eelstretching/led-budget-board/production/bom-full.csv

Comment | Designator | Footprint | LCSC | Manufacturer PN | Qty | Note
2.54-1*20P female header | A1A,A1B | PinSocket_1x20_P2.54mm_Vertical | C2905423 | Kinghelm KH-2.54FH-1X20P-H8.5 | 2 | Through-hole
10u | C1,C2 | C_0805_2012Metric | C440198 | CL21A106KBYNNNE | 2
100n | C3,C4 | C_0603_1608Metric | C14663 | CC0603KRX7R9BB104 | 2
75p | C5 | C_0402_1005Metric | C37809 | 0402CG750J500NT | 1
22u | C6,C7,C8 | C_0805_2012Metric | C45783 | CL21A226MAQNNNE | 3
100n | C9,C10,C11,C12 | C_0402_1005Metric | C1525 | CL05B104KO5NNNC | 4
SS34 | D1 | D_SMA | C8678 | SS34 | 1
B5819W | D2 | D_SOD-123 | C8598 | B5819W SL | 1
Green | D3 | LED_0603_1608Metric | C2289 | KT-0603YG | 1
12V IN | J1 | CONN-TH_2P-P9.50_DBT50G-9.5-2P | C395958 | DBT50G-9.5-2P | 1 | Through-hole
OUT1 | J2,J3 | IDC-Header_2x08_P2.54mm_Vertical | C3406 | 2.54-2*8P | 2 | Through-hole
UART | J4 | PinHeader_1x03_P2.54mm_Vertical | C49257 | 2.54-1*3P | 1 | Through-hole
I2C | J5 | PinHeader_1x04_P2.54mm_Vertical | C124378 | B-2100S04P-A110 | 1 | Through-hole
SPARE | J6 | PinHeader_1x08_P2.54mm_Vertical | C124381 | B-2100S08P-A110 | 1 | Through-hole
STEMMA QT | J7 | JST_SH_SM04B-SRSS-TB_1x04-1MP_P1.00mm_Horizontal | C160404 | SM04B-SRSS-TB(LF)(SN) | 1
15u | L1 | L_Sunlord_SWPA8040S | C16853 | SWPA8040S150MT | 1
510k | R1 | R_0402_1005Metric | C11616 | 0402WGF5103TCE | 1
100k | R2 | R_0402_1005Metric | C25741 | 0402WGF1003TCE | 1
13.3k | R3 | R_0402_1005Metric | C122547 | 0402WGF1332TCE | 1
1k | R4 | R_0402_1005Metric | C11702 | 0402WGF1001TCE | 1
33 | R5,R6,R7,R8,R9,R10,R11,R12,R13,R14,R15,R16,R17,R18,R19,R20 | R_0402_1005Metric | C25105 | 0402WGF330JTCE | 16
10k | R21,R22 | R_0402_1005Metric | C25744 | 0402WGF1002TCE | 2
RUN | SW1 | SW_SPST_TS-1088-xR025 | C455281 | TS-1088R-02526 | 1
TPS54202H | U1 | SOT-23-6 | C527684 | TPS54202HDDCR | 1
Pico 2 W | A1 | RaspberryPi_Pico_Common_THT |  | SC1633 | 1 | Not fitted by JLC: Raspberry Pi Pico 2 W (SC1633): yours, plugs into sockets A1A and A1B
M3 | H1 | MountingHole_3.2mm_M3 |  |  | 1 | Not fitted by JLC: M3 mounting hole
M3 | H2 | MountingHole_3.2mm_M3 |  |  | 1 | Not fitted by JLC: M3 mounting hole
M3 | H3 | MountingHole_3.2mm_M3 |  |  | 1 | Not fitted by JLC: M3 mounting hole
M3 | H4 | MountingHole_3.2mm_M3 |  |  | 1 | Not fitted by JLC: M3 mounting hole
