eelstretching/led-budget-board/docs/schematic.pdf

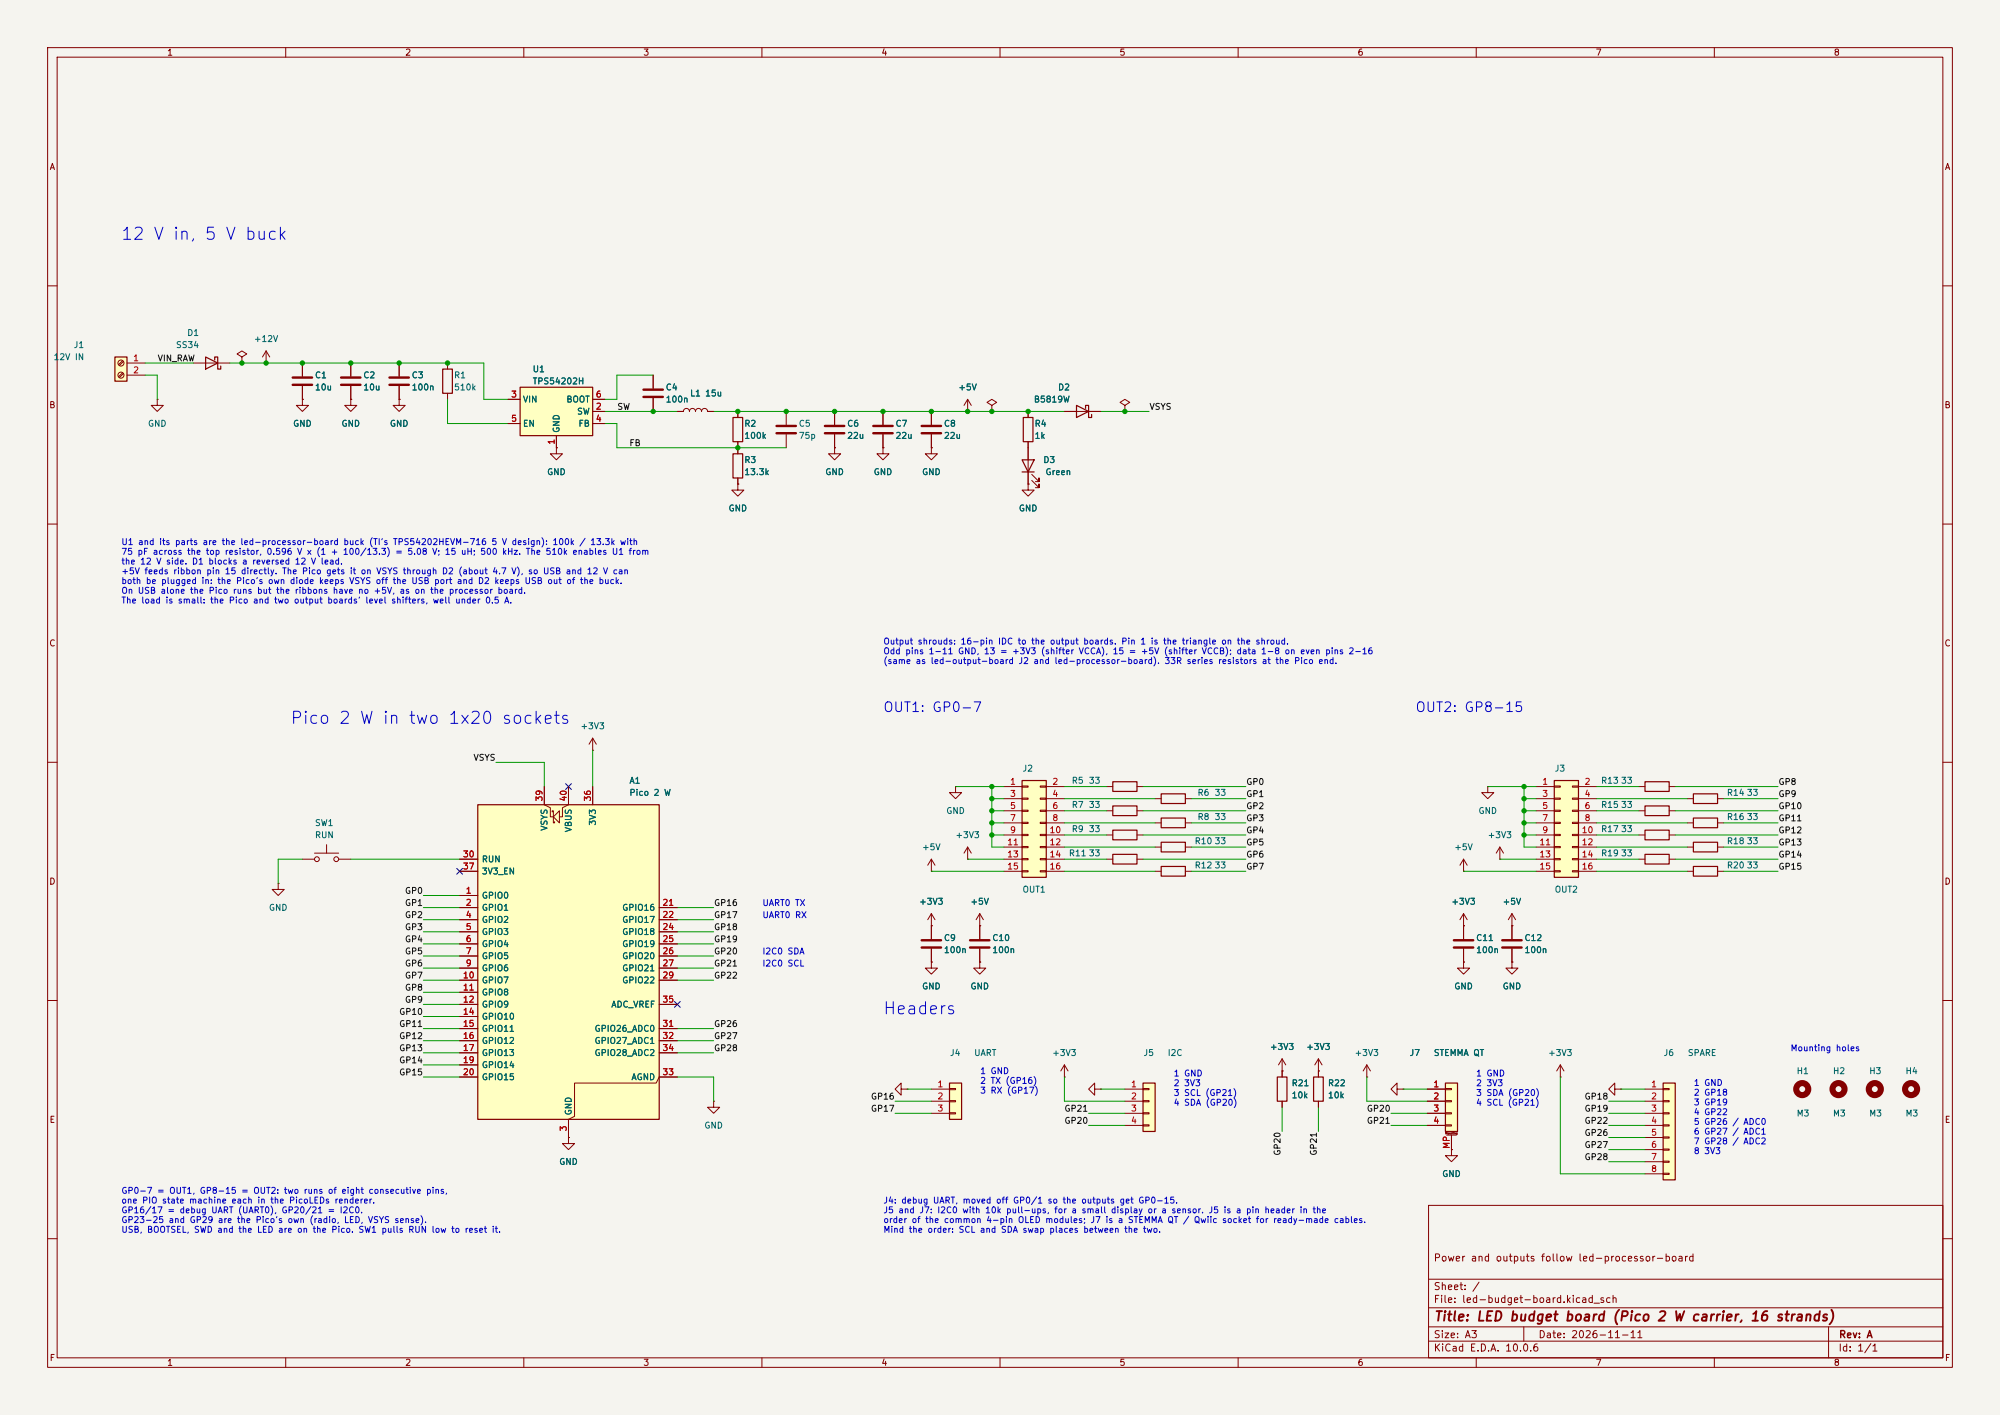
[picture p3: page 1]

U1 and its parts are the led-processor-board buck (TI's TPS54202HEVM-716 5 V design): 100k / 13.3k with 75 pF across the top resistor, 0.596 V x (1 + 100/13.3) = 5.08 V; 15 uH; 500 kHz. The 510k enables U1 from

the 12 V side. D1 blocks a reversed 12 V lead. +5V feeds ribbon pin 15 directly. The Pico gets it on VSYS through D2 (about 4.7 V), so USB and 12 V can

(same as led-output-board J2 and led-processor-board). 33R series resistors at the Pico end. Headers

3 SDA (GP20) 4 SCL (GP21) UART0 TX UART0 RX

GP0-7 = OUT1, GP8-15 = OUT2: two runs of eight consecutive pins, one PIO state machine each in the PicoLEDs renderer. GP16/17 = debug UART (UART0), GP20/21 = I2C0. GP23-25 and GP29 are the Pico's own (radio, LED, VSYS sense).

J4: debug UART, moved off GP0/1 so the outputs get GP0-15. J5 and J7: I2C0 with 10k pull-ups, for a small display or a sensor. J5 is a pin header in the order of the common 4-pin OLED modules; J7 is a STEMMA QT / Qwiic socket for ready-made cables. Mind the order: SCL and SDA swap places between the two.

Power and outputs follow led-processor-board

Sheet: /
File: led-budget-board.kicad_sch
Title: LED budget board (Pico 2 W carrier, 16 strands)

Size: A3 | Rev: A | F Date: 2026-11-11
KiCad E.D.A. 10.0.6 | Id: 1/1
