eelstretching/led-budget-board/led-budget-board.kicad_pcb

## KiCad design led-budget-board.kicad_pcb (2026-11-12)

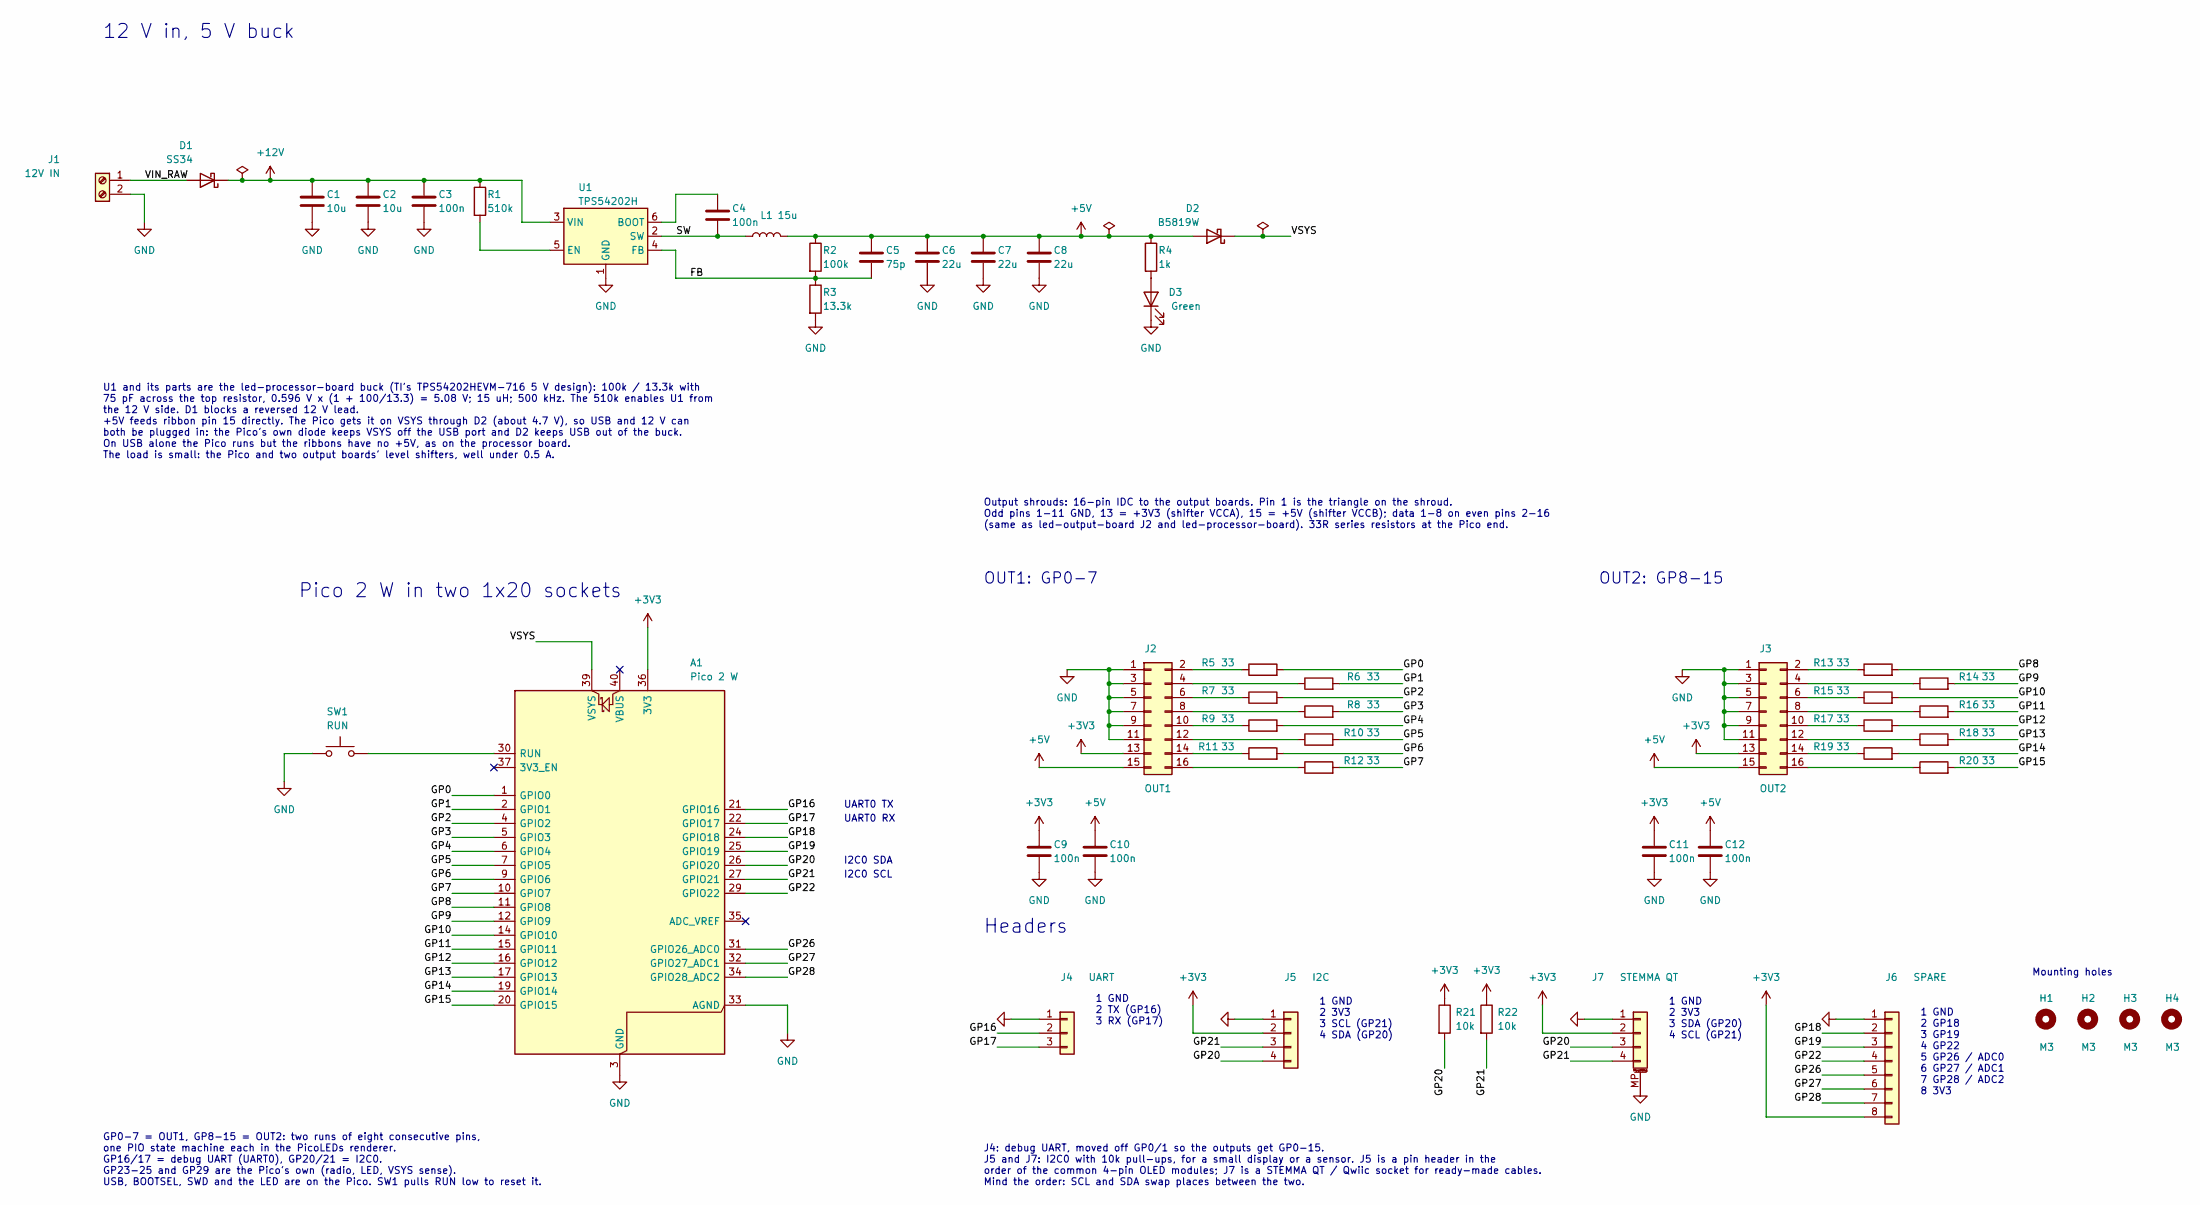
[picture p4: schematic led-budget-board.kicad_sch, LED budget board (Pico 2 W carrier, 16 strands)]

Parts:
A1: Pico 2 W; RaspberryPi_Pico_Common_THT; manufacturer_pn SC1633
C1, C2: 10u; C_0805_2012Metric; manufacturer_pn CL21A106KBYNNNE; LCSC C440198
C3, C4: 100n; C_0603_1608Metric; manufacturer_pn CC0603KRX7R9BB104; LCSC C14663
C5: 75p; C_0402_1005Metric; manufacturer_pn 0402CG750J500NT; LCSC C37809
C6, C7, C8: 22u; C_0805_2012Metric; manufacturer_pn CL21A226MAQNNNE; LCSC C45783
C9, C10, C11, C12: 100n; C_0402_1005Metric; manufacturer_pn CL05B104KO5NNNC; LCSC C1525
D1: SS34; D_SMA; manufacturer_pn SS34; LCSC C8678
D2: B5819W; D_SOD-123; manufacturer_pn B5819W SL; LCSC C8598
D3: Green; LED_0603_1608Metric; manufacturer_pn KT-0603YG; LCSC C2289
H1, H2, H3, H4: M3; MountingHole_3.2mm_M3
J1: 12V IN; CONN-TH_2P-P9.50_DBT50G-9.5-2P; manufacturer_pn DBT50G-9.5-2P; LCSC C395958
J2: OUT1; IDC-Header_2x08_P2.54mm_Vertical; manufacturer_pn 2.54-2*8P; LCSC C3406
J3: OUT2; IDC-Header_2x08_P2.54mm_Vertical; manufacturer_pn 2.54-2*8P; LCSC C3406
J4: UART; PinHeader_1x03_P2.54mm_Vertical; manufacturer_pn 2.54-1*3P; LCSC C49257
J5: I2C; PinHeader_1x04_P2.54mm_Vertical; manufacturer_pn B-2100S04P-A110; LCSC C124378
J6: SPARE; PinHeader_1x08_P2.54mm_Vertical; manufacturer_pn B-2100S08P-A110; LCSC C124381
J7: STEMMA QT; JST_SH_SM04B-SRSS-TB_1x04-1MP_P1.00mm_Horizontal; manufacturer_pn SM04B-SRSS-TB(LF)(SN); LCSC C160404
L1: 15u; L_Sunlord_SWPA8040S; manufacturer_pn SWPA8040S150MT; LCSC C16853
R1: 510k; R_0402_1005Metric; manufacturer_pn 0402WGF5103TCE; LCSC C11616
R2: 100k; R_0402_1005Metric; manufacturer_pn 0402WGF1003TCE; LCSC C25741
R3: 13.3k; R_0402_1005Metric; manufacturer_pn 0402WGF1332TCE; LCSC C122547
R4: 1k; R_0402_1005Metric; manufacturer_pn 0402WGF1001TCE; LCSC C11702
R5, R6, R7, R8, R9, R10, R11, R12, R13, R14, R15, R16, R17, R18, R19, R20: 33; R_0402_1005Metric; manufacturer_pn 0402WGF330JTCE; LCSC C25105
R21, R22: 10k; R_0402_1005Metric; manufacturer_pn 0402WGF1002TCE; LCSC C25744
SW1: RUN; SW_SPST_TS-1088-xR025; manufacturer_pn TS-1088R-02526; LCSC C455281
U1: TPS54202H; SOT-23-6; manufacturer_pn TPS54202HDDCR; LCSC C527684

Connections:
+3V3: A1.36 (3V3), C9.1, C11.1, J2.13, J3.13, J5.2, J6.8, J7.2, R21.1, R22.1
+5V: C5.1, C6.1, C7.1, C8.1, C10.1, C12.1, D2.2 (A), J2.15, J3.15, L1.2, R2.1, R4.1
+12V: C1.1, C2.1, C3.1, D1.1 (K), R1.1, U1.3 (VIN)
/FB: C5.2, R2.2, R3.1, U1.4 (FB)
/GP0: A1.1 (GPIO0), R5.2
/GP1: A1.2 (GPIO1), R6.2
/GP2: A1.4 (GPIO2), R7.2
/GP3: A1.5 (GPIO3), R8.2
/GP4: A1.6 (GPIO4), R9.2
/GP5: A1.7 (GPIO5), R10.2
/GP6: A1.9 (GPIO6), R11.2
/GP7: A1.10 (GPIO7), R12.2
/GP8: A1.11 (GPIO8), R13.2
/GP9: A1.12 (GPIO9), R14.2
/GP10: A1.14 (GPIO10), R15.2
/GP11: A1.15 (GPIO11), R16.2
/GP12: A1.16 (GPIO12), R17.2
/GP13: A1.17 (GPIO13), R18.2
/GP14: A1.19 (GPIO14), R19.2
/GP15: A1.20 (GPIO15), R20.2
/GP16: A1.21 (GPIO16), J4.2
/GP17: A1.22 (GPIO17), J4.3
/GP18: A1.24 (GPIO18), J6.2
/GP19: A1.25 (GPIO19), J6.3
/GP20: A1.26 (GPIO20), J5.4, J7.3, R21.2
/GP21: A1.27 (GPIO21), J5.3, J7.4, R22.2
/GP22: A1.29 (GPIO22), J6.4
/GP26: A1.31 (GPIO26_ADC0), J6.5
/GP27: A1.32 (GPIO27_ADC1), J6.6
/GP28: A1.34 (GPIO28_ADC2), J6.7
/SW: C4.2, L1.1, U1.2 (SW)
/VIN_RAW: D1.2 (A), J1.1
/VSYS: A1.39 (VSYS), D2.1 (K)
GND: A1.3 (GND), A1.8 (GND), A1.13 (GND), A1.18 (GND), A1.23 (GND), A1.28 (GND), A1.33 (AGND), A1.38 (GND), C1.2, C2.2, C3.2, C6.2, C7.2, C8.2, C9.2, C10.2, C11.2, C12.2, D3.1 (K), J1.2, J2.1, J2.3, J2.5, J2.7, J2.9, J2.11, J3.1, J3.3, J3.5, J3.7, J3.9, J3.11, J4.1, J5.1, J6.1, J7.1, J7.MP (MountPin), R3.2, SW1.1, U1.1 (GND)
unnamed: A1.30 (RUN), SW1.2
unnamed: D3.2 (A), R4.2
unnamed: J2.2, R5.1
unnamed: J2.4, R6.1
unnamed: J2.6, R7.1
unnamed: J2.8, R8.1
unnamed: J2.10, R9.1
unnamed: J2.12, R10.1
unnamed: J2.14, R11.1
unnamed: J2.16, R12.1
unnamed: J3.2, R13.1
unnamed: J3.4, R14.1
unnamed: J3.6, R15.1
unnamed: J3.8, R16.1
unnamed: J3.10, R17.1
unnamed: J3.12, R18.1
unnamed: J3.14, R19.1
unnamed: J3.16, R20.1
unnamed: C4.1, U1.6 (BOOT)
unnamed: R1.2, U1.5 (EN)

Notes on the sheet:
12 V in, 5 V buck
U1 and its parts are the led-processor-board buck (TI's TPS54202HEVM-716 5 V design): 100k / 13.3k with 75 pF across the top resistor, 0.596 V x (1 + 100/13.3) = 5.08 V; 15 uH; 500 kHz. The 510k enables U1 from the 12 V side. D1 blocks a reversed 12 V lead. +5V feeds ribbon pin 15 directly. The Pic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
Pico 2 W in two 1x20 sockets
UART0 TX
UART0 RX
I2C0 SDA
I2C0 SCL
GP0-7 = OUT1, GP8-15 = OUT2: two runs of eight consecutive pins, one PIO state machine each in the PicoLEDs renderer. GP16/17 = debug UART (UART0), GP20/21 = I2C0. GP23-25 and GP29 are the Pico's own (radio, LED, VSYS sense). USB, BOOTSEL, SWD and the LED are on the Pico. SW1 pulls RUN low to reset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
Output shrouds: 16-pin IDC to the output boards. Pin 1 is the triangle on the shroud. Odd pins 1-11 GND, 13 = +3V3 (shifter VCCA), 15 = +5V (shifter VCCB); data 1-8 on even pins 2-16 (same as led-output-board J2 and led-processor-board). 33R series resistors at the Pico end.
OUT1: GP0-7
OUT2: GP8-15
Headers
1 GND 2 TX (GP16) 3 RX (GP17)
1 GND 2 3V3 3 SCL (GP21) 4 SDA (GP20)
1 GND 2 3V3 3 SDA (GP20) 4 SCL (GP21)
1 GND 2 GP18 3 GP19 4 GP22 5 GP26 / ADC0 6 GP27 / ADC1 7 GP28 / ADC2 8 3V3
J4: debug UART, moved off GP0/1 so the outputs get GP0-15. J5 and J7: I2C0 with 10k pull-ups, for a small display or a sensor. J5 is a pin header in the order of the common 4-pin OLED modules; J7 is a STEMMA QT / Qwiic socket for ready-made cables. Mind the order: SCL and SDA swap places between th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
Mounting holes

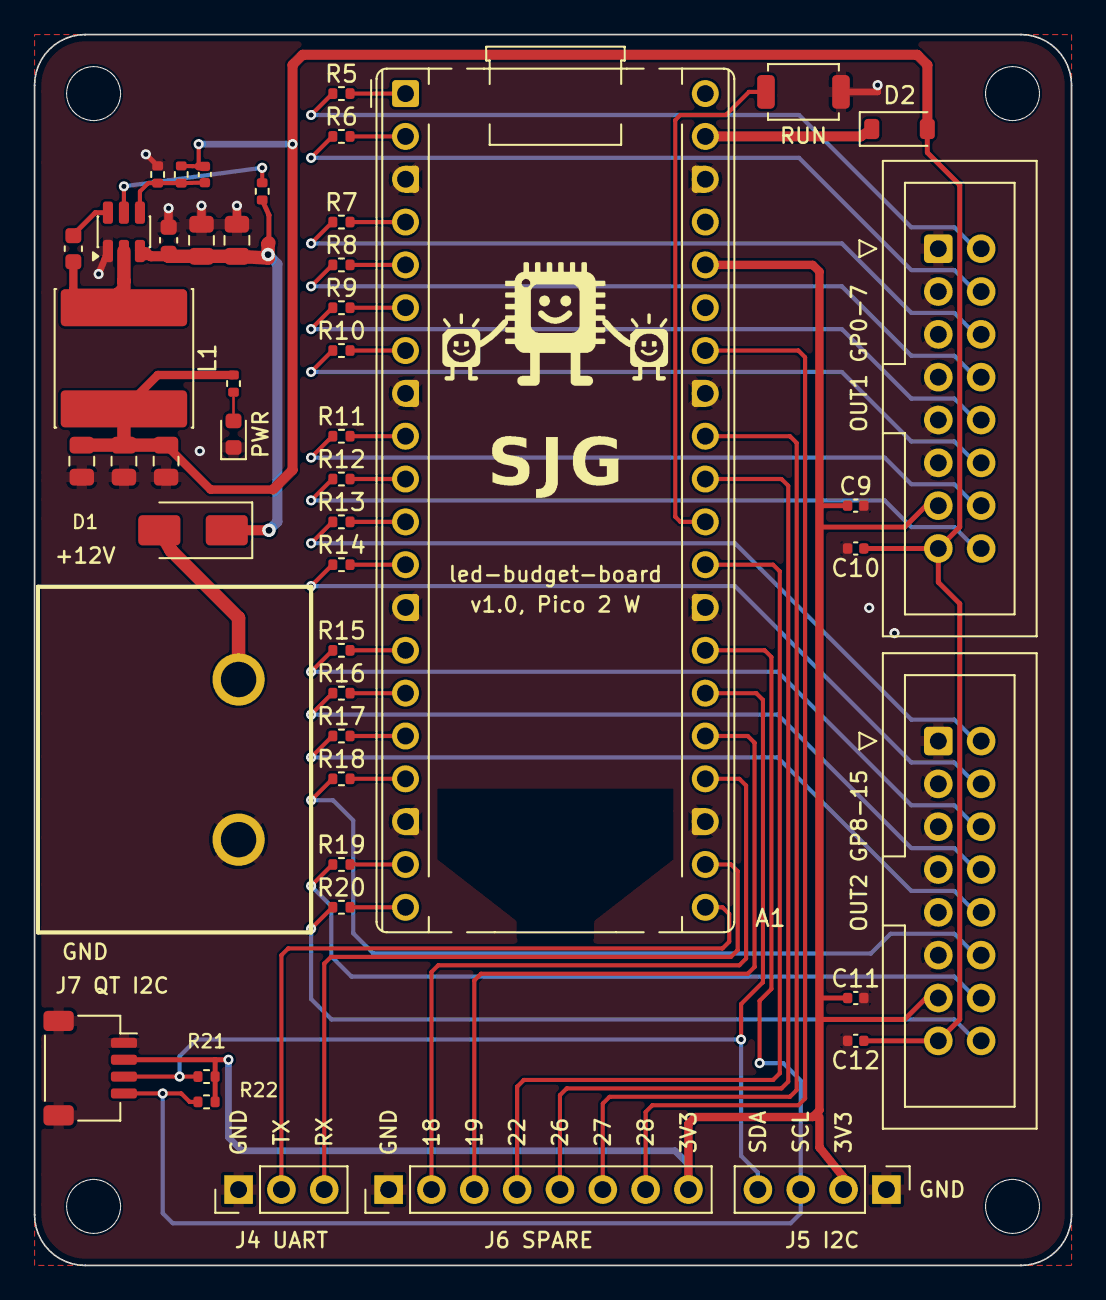
[picture p5: board led-budget-board.kicad_pcb from above]

Board: 2 copper layers, 61.5 x 73.0 mm, 53 parts (0 on the bottom side), 54 nets.

Other parts of the board:
G1: SJG_BigBrother
