eelstretching/led-budget-board/(commit log)

2026-11-11 Add the schematic: Pico 2 W carrier with two output shrouds
    One A3 sheet: a socketed Pico 2 W, OUT1 on GP0-7 and OUT2 on GP8-15 with
    33R series resistors, the led-processor-board 12 V to 5 V buck feeding the
    ribbons and (through a Schottky) the Pico's VSYS, debug UART header on
    GP16/17, I2C header on GP20/21, spare GPIO header, RUN button, mounting
    holes. ERC is clean.
    Claude-Session: https://claude.ai/code/session_01NSi48ZqyhrwW7HN2P3fnKd
    [led-budget-board.kicad_sch]
2026-11-11 Add a STEMMA QT socket on the I2C bus
    J7, a JST SH 4-pin socket (SM04B-SRSS-TB, LCSC C160404) in the STEMMA QT /
    Qwiic pin order (GND, 3V3, SDA, SCL), in parallel with the J5 pin header on
    GP20/GP21. Headers moved closer together to make room. ERC is clean.
    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
    [led-budget-board.kicad_sch]
2026-11-11 Start the PCB layout: placement and the planned data lines
    tools/pcb/build_pcb.py places every part, draws the 61.5 x 73 mm outline,
    routes the 16 data lines (33R next to the Pico, then across under the Pico
    on the bottom layer to the two shrouds on the right edge) and copies the
    processor board's 5 V buck layout. Not routed yet: power distribution,
    headers, button.
    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
    [led-budget-board.kicad_pcb]
2026-11-11 Route the board: all nets connected, DRC clean
    Hand-routed by tools/pcb/build_pcb.py: 12 V input, 5 V trunk to D2/VSYS and the
    shrouds, 3.3 V, RUN, UART, spare I/O and I2C (J5 header and J7 STEMMA QT).
    J6 pin order is now GND, GP18, GP19, GP22, GP26-28, 3V3 so the tracks reach it
    without crossing. RUN button and D2 moved to the top right; headers re-ordered
    along the bottom edge. Silkscreen labels for every connector pin.
    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
    [led-budget-board.kicad_pcb, led-budget-board.kicad_sch]
2026-11-11 Add the logo to the silkscreen
    The processor board's SJG logo, scaled to 14 mm, left of the Pico.
    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
    [led-budget-board.kicad_pcb]
2026-11-11 12 V input: the output boards' barrier terminal, on a strip down the left edge
    J1 is now the DBT50G-9.5-2P (LCSC C395958) that the output boards use, so the
    same 14 AWG feed fits. The board grows 17.5 mm to the left (79 x 73 mm) so the
    whole housing sits on the board with the wire entry facing the edge. The STEMMA
    QT socket moves to the new edge and the logo goes back to full size below J1.
    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
    [led-budget-board.kicad_pcb, led-budget-board.kicad_sch]
2026-11-11 Fit the 12 V barrier terminal on the original 61.5 x 73 mm board
    Steve would rather lose the logo's spot than grow the board. The buck moves up
    into the old terminal's place, D1 sits below it and J1 below that, wire entry
    facing the left edge. +12 V crosses the 5 V output on the bottom layer. The
    logo (14 mm) and the board name go under the Pico.
    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
    [led-budget-board.kicad_pcb]
2026-11-12 Add the JLCPCB files for full assembly
    tools/jlc.py writes production/: gerbers, BOM and placement file covering the
    SMD and the through-hole parts. The shrouds and pin headers get LCSC numbers
    in the schematic; the Pico's two 1x20 sockets are added by the script as A1A
    and A1B, since A1 itself (the Pico) is not fitted by JLC.
    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
    [bom-full.csv, jlcpcb-bom.csv, led-budget-board.kicad_pcb, led-budget-board.kicad_sch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]
2026-11-12 Pico sockets: Kinghelm C2905423, as ordered
    BOOMELE C50984 was out of stock at JLCPCB when Steve placed the order
    (2026-11-12); this is the same 1x20 2.54 mm female header from another maker.
    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
    [bom-full.csv, jlcpcb-bom.csv]
2026-11-12 Placement file: turn the shrouds, sockets and pin headers a quarter turn
    JLC's placement preview showed them 90 degrees off: their models for these
    parts lie a quarter turn anticlockwise of KiCad's footprints.
    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
    [jlcpcb-cpl.csv]
